MiPaGitH/magEncAWAGO/el/nucleoF303ZE_AEAT6000Control/AEAT6000ControlSchematicUsingNucleoF303ZE.bmp

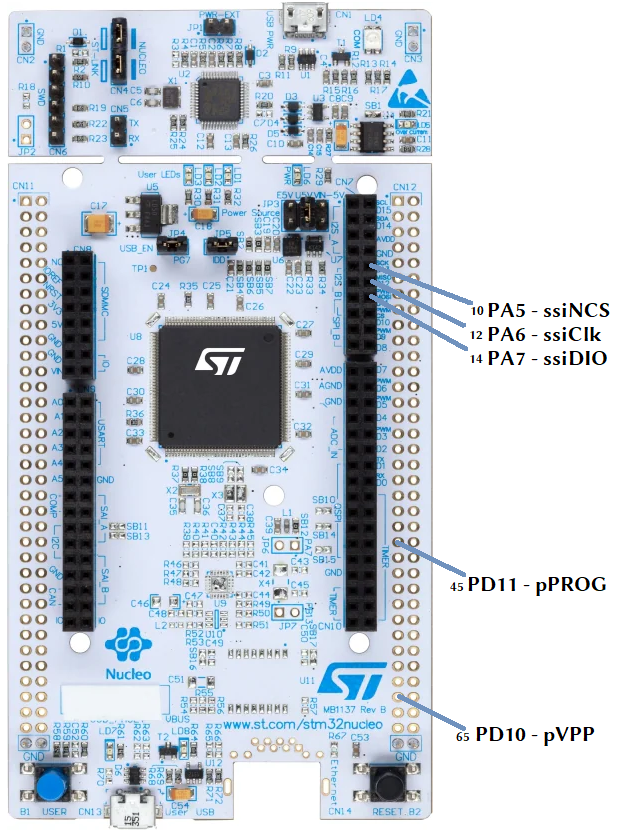
el/nucleoF303ZE_AEAT6000Control/AEAT6000ControlSchematicUsingNucleoF303ZE.bmp
