MiPaGitH/magEncAWAGO/README.md

# magEncAWAGO
interface for AWAGO magnetic encoder (configuration and data acquisition)
includes also PCB design (with AWAGO AEAT6600) done in KiCad
TODO - add option at runtime to switch from config mode to data mode
TODO - code cleanup
