MiPaGitH/magEncAWAGO/(list of files, drawings)

Other design files:
el/magEncAEAT6600/magEncAEAT6600.dsn
