MiPaGitH/magEncAWAGO/el/magEncAEAT6600/magEncAEAT6600.kicad_pcb

## KiCad design el/magEncAEAT6600/magEncAEAT6600.kicad_pcb (2025-04-05)

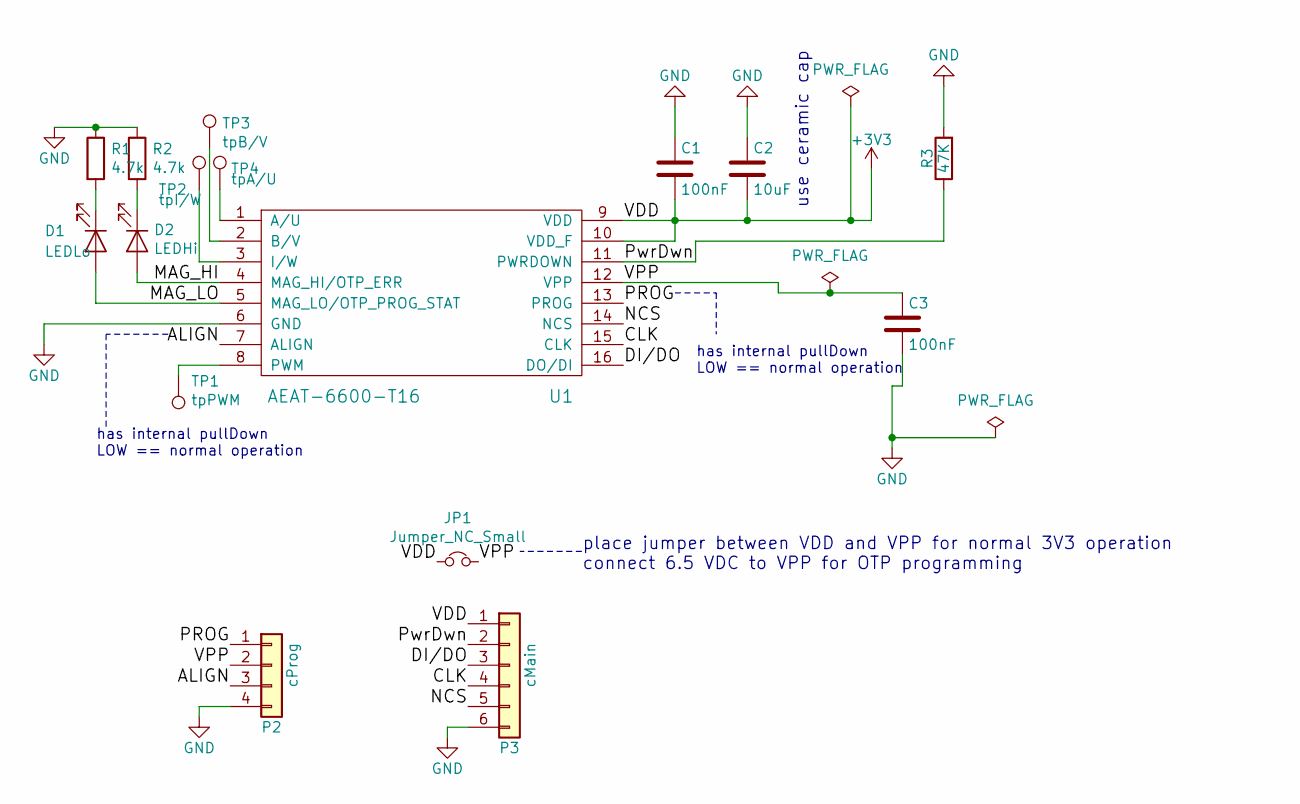
[picture p2: schematic magEncAEAT6600.sch]

Parts:
C1, C3: 100nF; C_1206_3216Metric_Pad1.42x1.75mm_HandSolder
C2: 10uF; C_1210_3225Metric_Pad1.42x2.65mm_HandSolder
D1: LEDLo; LED_1206_3216Metric_Pad1.42x1.75mm_HandSolder
D2: LEDHi; LED_1206_3216Metric_Pad1.42x1.75mm_HandSolder
JP1: Jumper_NC_Small; SolderJumper-2_P1.3mm_Open_TrianglePad1.0x1.5mm
P2: cProg; PinHeader_1x04_P2.54mm_Vertical
P3: cMain; PinHeader_1x06_P2.54mm_Vertical
R1, R2: 4.7k; R_1206_3216Metric_Pad1.42x1.75mm_HandSolder
R3: 47K; R_1206_3216Metric_Pad1.42x1.75mm_HandSolder
TP1: tpPWM; TestPoint_THTPad_D1.0mm_Drill0.5mm
TP2: tpI/W; TestPoint_THTPad_D1.0mm_Drill0.5mm
TP3: tpB/V; TestPoint_THTPad_D1.0mm_Drill0.5mm
TP4: tpA/U; TestPoint_THTPad_D1.0mm_Drill0.5mm
U1: AEAT-6600-T16; TSSOP-16_4.4x5mm_P0.65mm

Connections:
+3V3: C1.2, C2.2, JP1.1, P3.1, U1.9 (VDD), U1.10 (VDD_F)
/ALIGN: P2.3, U1.7 (ALIGN)
/CLK: P3.4, U1.15 (CLK)
/DI/DO: P3.3, U1.16 (DO/DI)
/MAG_HI: D2.2 (A), U1.4 (MAG_HI/OTP_ERR)
/MAG_LO: D1.2 (A), U1.5 (MAG_LO/OTP_PROG_STAT)
/NCS: P3.5, U1.14 (NCS)
/PROG: P2.1, U1.13 (PROG)
/PwrDwn: P3.2, R3.1, U1.11 (PWRDOWN)
/VPP: C3.1, JP1.2, P2.2, U1.12 (VPP)
GND: C1.1, C2.1, C3.2, P2.4, P3.6, R1.1, R2.1, R3.2, U1.6 (GND)
unnamed: D1.1 (K), R1.2
unnamed: D2.1 (K), R2.2
unnamed: TP1.1, U1.8 (PWM)
unnamed: TP2.1, U1.3 (I/W)
unnamed: TP3.1, U1.2 (B/V)
unnamed: TP4.1, U1.1 (A/U)

Notes on the sheet:
use ceramic cap
place jumper between VDD and VPP for normal 3V3 operation connect 6.5 VDC to VPP for OTP programming
has internal pullDown LOW == normal operation

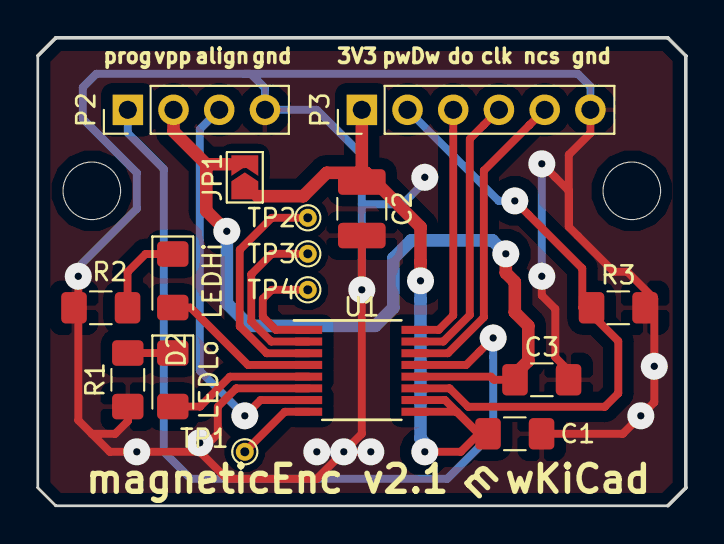
[picture p3: board magEncAEAT6600.kicad_pcb from above]

Board: 2 copper layers, 36.0 x 26.0 mm, 18 parts (0 on the bottom side), 17 nets.

Other parts of the board:
1, 2: MountingHole_3.2mm_M3
