MiPaGitH/magEncAWAGO/sw/AEAT6600ConfigAndReadData/Core/Src/main.c

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
/* Includes ------------------------------------------------------------------*/
#include "main.h"

/* USER CODE BEGIN Includes */
#include "..\..\app\uart\u.h"
/* USER CODE END Includes */

/* USER CODE BEGIN PD */
#define OTPDATA_bits31_16_ZeroPosition 0x00u /*(ZeroHI and LO - bits 31..16; )*/

//Inc Resolution Bits = 1024 CPR (bits 0,1,2)
//Absolute resolution = 12 bits (bit 8)
//Incremental select bit 10 remains 0 - ABI mode
//Incremental enable (bit 11)
#define OTPDATA_bits_15_0_ModeHI_and_LO (1u<<11) + (1u<<8) + 0x07u

/* USER CODE END PD */

TIM_HandleTypeDef htim1;

UART_HandleTypeDef huart3;
DMA_HandleTypeDef hdma_usart3_tx;
DMA_HandleTypeDef hdma_usart3_rx;

/* USER CODE BEGIN PV */

uint32_t inputData;
uint32_t inputDataFirstRead;
uint32_t inputDataSecondRead;


uint32_t evenParBit = 1u; //because there are 5 bits with value 1 in otpData; even parity means that total number of bits with value 1 must be even

uint32_t cntClkRisingEdge;

uint8_t mData[2];
uint16_t mData16;

uint32_t mSysTick;
uint32_t oldTick;
uint32_t oldBtn;

uint8_t csPinState;
uint8_t dataPinState;
uint8_t clkPinState;
uint8_t pState;
uint8_t oldpState;

uint8_t doInputMode;

uint8_t inputParBit;
uint8_t inputParBitFirstRead;
uint8_t inputParBitSecondRead;
uint8_t evTim1Tick;

uint8_t pStBuf[255];
uint8_t cPStateBuf;

volatile uint8_t btnPressed;


/* USER CODE END PV */

void SystemClock_Config(void);
static void MX_GPIO_Init(void);
static void MX_DMA_Init(void);
static void MX_TIM1_Init(void);
static void MX_USART3_UART_Init(void);
/**
  * @brief  The application entry point.
  * @retval int
  */
int main(void)
{
  /* USER CODE BEGIN 1 */
//	GPIO_InitTypeDef GPIO_InitStruct = {0};

//	uint8_t fSetPin2InputMode = 0u;
	oldTick = 0u;
	oldBtn = 10000u;
	csPinState = GPIO_PIN_SET;
	dataPinState = GPIO_PIN_SET;
	clkPinState = GPIO_PIN_SET;
	cntClkRisingEdge = 0u;
	btnPressed = 0u;
	doInputMode = 0u;
	evTim1Tick = 0u;

	pState = 0u;
	oldpState = 0u;

	cPStateBuf = 0u;

	mData[0]=0u;
	mData[1]=0u;

  /* USER CODE END 1 */

  /* MCU Configuration--------------------------------------------------------*/

  /* Reset of all peripherals, Initializes the Flash interface and the Systick. */
  HAL_Init();

  /* USER CODE BEGIN Init */
  uInit();

  /* USER CODE END Init */

  /* Configure the system clock */
  SystemClock_Config();

  /* Initialize all configured peripherals */
  MX_GPIO_Init();
  MX_DMA_Init();
  MX_TIM1_Init();
  MX_USART3_UART_Init();
  /* USER CODE BEGIN 2 */
  HAL_GPIO_WritePin(GPIOA, ssiNCS_Pin|ssiClk_Pin|ssiDIO_Pin, GPIO_PIN_SET);
  /* USER CODE END 2 */

  /* Infinite loop */
  /* USER CODE BEGIN WHILE */
  while (1)
  {
//	  uint8_t nBtn = GPIO_PIN_RESET;
//	  nBtn = HAL_GPIO_ReadPin(USER_Btn_GPIO_Port, USER_Btn_Pin);
	  mSysTick = HAL_GetTick();
	  if ( (oldTick!=mSysTick) /*&& (0u == (mSysTick%25))*/ )
	  {
//		  mData16 = ((((uint16_t)mData[1]&0x3F)<<8) + mData[0])>>4;
//		  HAL_GPIO_TogglePin(GPIOA, ssiNCS_Pin);
		  uTask();
		  oldTick = mSysTick;
	  }

    /* USER CODE END WHILE */

    /* USER CODE BEGIN 3 */
  }
  /* USER CODE END 3 */
}

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
