MiPaGitH/magEncAWAGO/sw/AEAT6600ConfigAndReadData/AEAT6600ConfigAndReadData.ioc

Mcu.UserName=STM32F303ZETx
PA11.GPIO_Label=USB_DM
PA11.Signal=USB_DM
PA12.GPIO_Label=USB_DP
PA12.Signal=USB_DP
PA13.GPIO_Label=TMS
PA13.Signal=SYS_JTMS-SWDIO
PA14.GPIO_Label=TCK
PA14.Signal=SYS_JTCK-SWCLK
PA5.GPIO_Label=ssiNCS
PA5.Signal=GPIO_Output
PA6.GPIO_Label=ssiClk
PA6.Signal=GPIO_Output
PA7.GPIO_Label=ssiDIO
PA7.Signal=GPIO_Output
PB0.GPIO_Label=LD1 [Green]
PB0.Signal=GPIO_Output
PB12.GPIO_Label=testPin
PB12.Signal=GPIO_Output
PB14.GPIO_Label=LD3 [Red]
PB14.Signal=GPIO_Output
PB3.GPIO_Label=SWO
PB3.Signal=SYS_JTDO-TRACESWO
PB7.GPIO_Label=LD2 [Blue]
PB7.Signal=GPIO_Output
PC13.GPIO_Label=USER_Btn [B1]
PC13.Signal=GPXTI13
PC14-OSC32_IN.Signal=RCC_OSC32_IN
PC15-OSC32_OUT.Signal=RCC_OSC32_OUT
PD10.GPIO_Label=pVPP
PD10.Signal=GPIO_Output
PD11.GPIO_Label=pPROG
PD11.Signal=GPIO_Output
PD8.GPIO_Label=STLK_RX [STM32F103CBT6_PA3]
PD8.Signal=USART3_TX
PD9.GPIO_Label=STLK_TX [STM32F103CBT6_PA2]
PD9.Signal=USART3_RX
PF0-OSC_IN.GPIO_Label=MCO [STM32F103CBT6_PA8]
PF0-OSC_IN.Signal=RCC_OSC_IN
PG6.GPIO_Label=USB_PowerSwitchOn [STMPS2151STR_EN]
PG6.Signal=GPIO_Output
PG7.GPIO_Label=USB_OverCurrent [STMPS2151STR_FAULT]
PG7.Signal=GPIO_Input
