MiPaGitH/magEncAWAGO/sw/AEAT6600ConfigAndReadData/Core/Inc/main.h

#define USER_Btn_Pin GPIO_PIN_13
#define USER_Btn_GPIO_Port GPIOC
#define MCO_Pin GPIO_PIN_0
#define MCO_GPIO_Port GPIOF
#define ssiNCS_Pin GPIO_PIN_5
#define ssiNCS_GPIO_Port GPIOA
#define ssiClk_Pin GPIO_PIN_6
#define ssiClk_GPIO_Port GPIOA
#define ssiDIO_Pin GPIO_PIN_7
#define ssiDIO_GPIO_Port GPIOA
#define LD1_Pin GPIO_PIN_0
#define LD1_GPIO_Port GPIOB
#define testPin_Pin GPIO_PIN_12
#define testPin_GPIO_Port GPIOB
#define LD3_Pin GPIO_PIN_14
#define LD3_GPIO_Port GPIOB
#define STLK_RX_Pin GPIO_PIN_8
#define STLK_RX_GPIO_Port GPIOD
#define STLK_TX_Pin GPIO_PIN_9
#define STLK_TX_GPIO_Port GPIOD
#define pVPP_Pin GPIO_PIN_10
#define pVPP_GPIO_Port GPIOD
#define pPROG_Pin GPIO_PIN_11
#define pPROG_GPIO_Port GPIOD
#define USB_PowerSwitchOn_Pin GPIO_PIN_6
#define USB_PowerSwitchOn_GPIO_Port GPIOG
#define USB_OverCurrent_Pin GPIO_PIN_7
#define USB_OverCurrent_GPIO_Port GPIOG
#define USB_DM_Pin GPIO_PIN_11
#define USB_DM_GPIO_Port GPIOA
#define USB_DP_Pin GPIO_PIN_12
#define USB_DP_GPIO_Port GPIOA
#define TMS_Pin GPIO_PIN_13
#define TMS_GPIO_Port GPIOA
#define TCK_Pin GPIO_PIN_14
#define TCK_GPIO_Port GPIOA
#define SWO_Pin GPIO_PIN_3
#define SWO_GPIO_Port GPIOB
#define LD2_Pin GPIO_PIN_7
#define LD2_GPIO_Port GPIOB
