MiPaGitH/magEncAWAGO/(commit log)

2025-04-05 pcb design tested successfully; initial sw version (see TODO's)
    [magEncAEAT6600-2019-01-27-03-04-06.sch, magEncAEAT6600.dsn, magEncAEAT6600.kicad_pcb, magEncAEAT6600.sch]
2025-04-06 added uart menu; uart com tested with putty
2025-04-18 added code to process the RX SSI data of encoder value
2025-06-07 uart commands management updated (using HAL_UARTEx_ReceiveToIdle_DMA)
2025-06-09 fix menu processing; now is shown correctly
    [u.c]
2025-07-06 menu commands display corrected; added simple schematic of NucleoF303ZE
    [AEAT6600ConfigAndReadData.ioc, main.c, main.h, u.c]
2025-07-13 bug fixes to menu processing and so command; now all commands work correctly
    [u.c]
